robwiegman/luminixie/(list of files, drawings)

Other design files:
pcb/luminixie.dsn
