robwiegman/luminixie/pcb/luminixie.kicad_pcb

## KiCad design pcb/luminixie.kicad_pcb (2019-10-02)

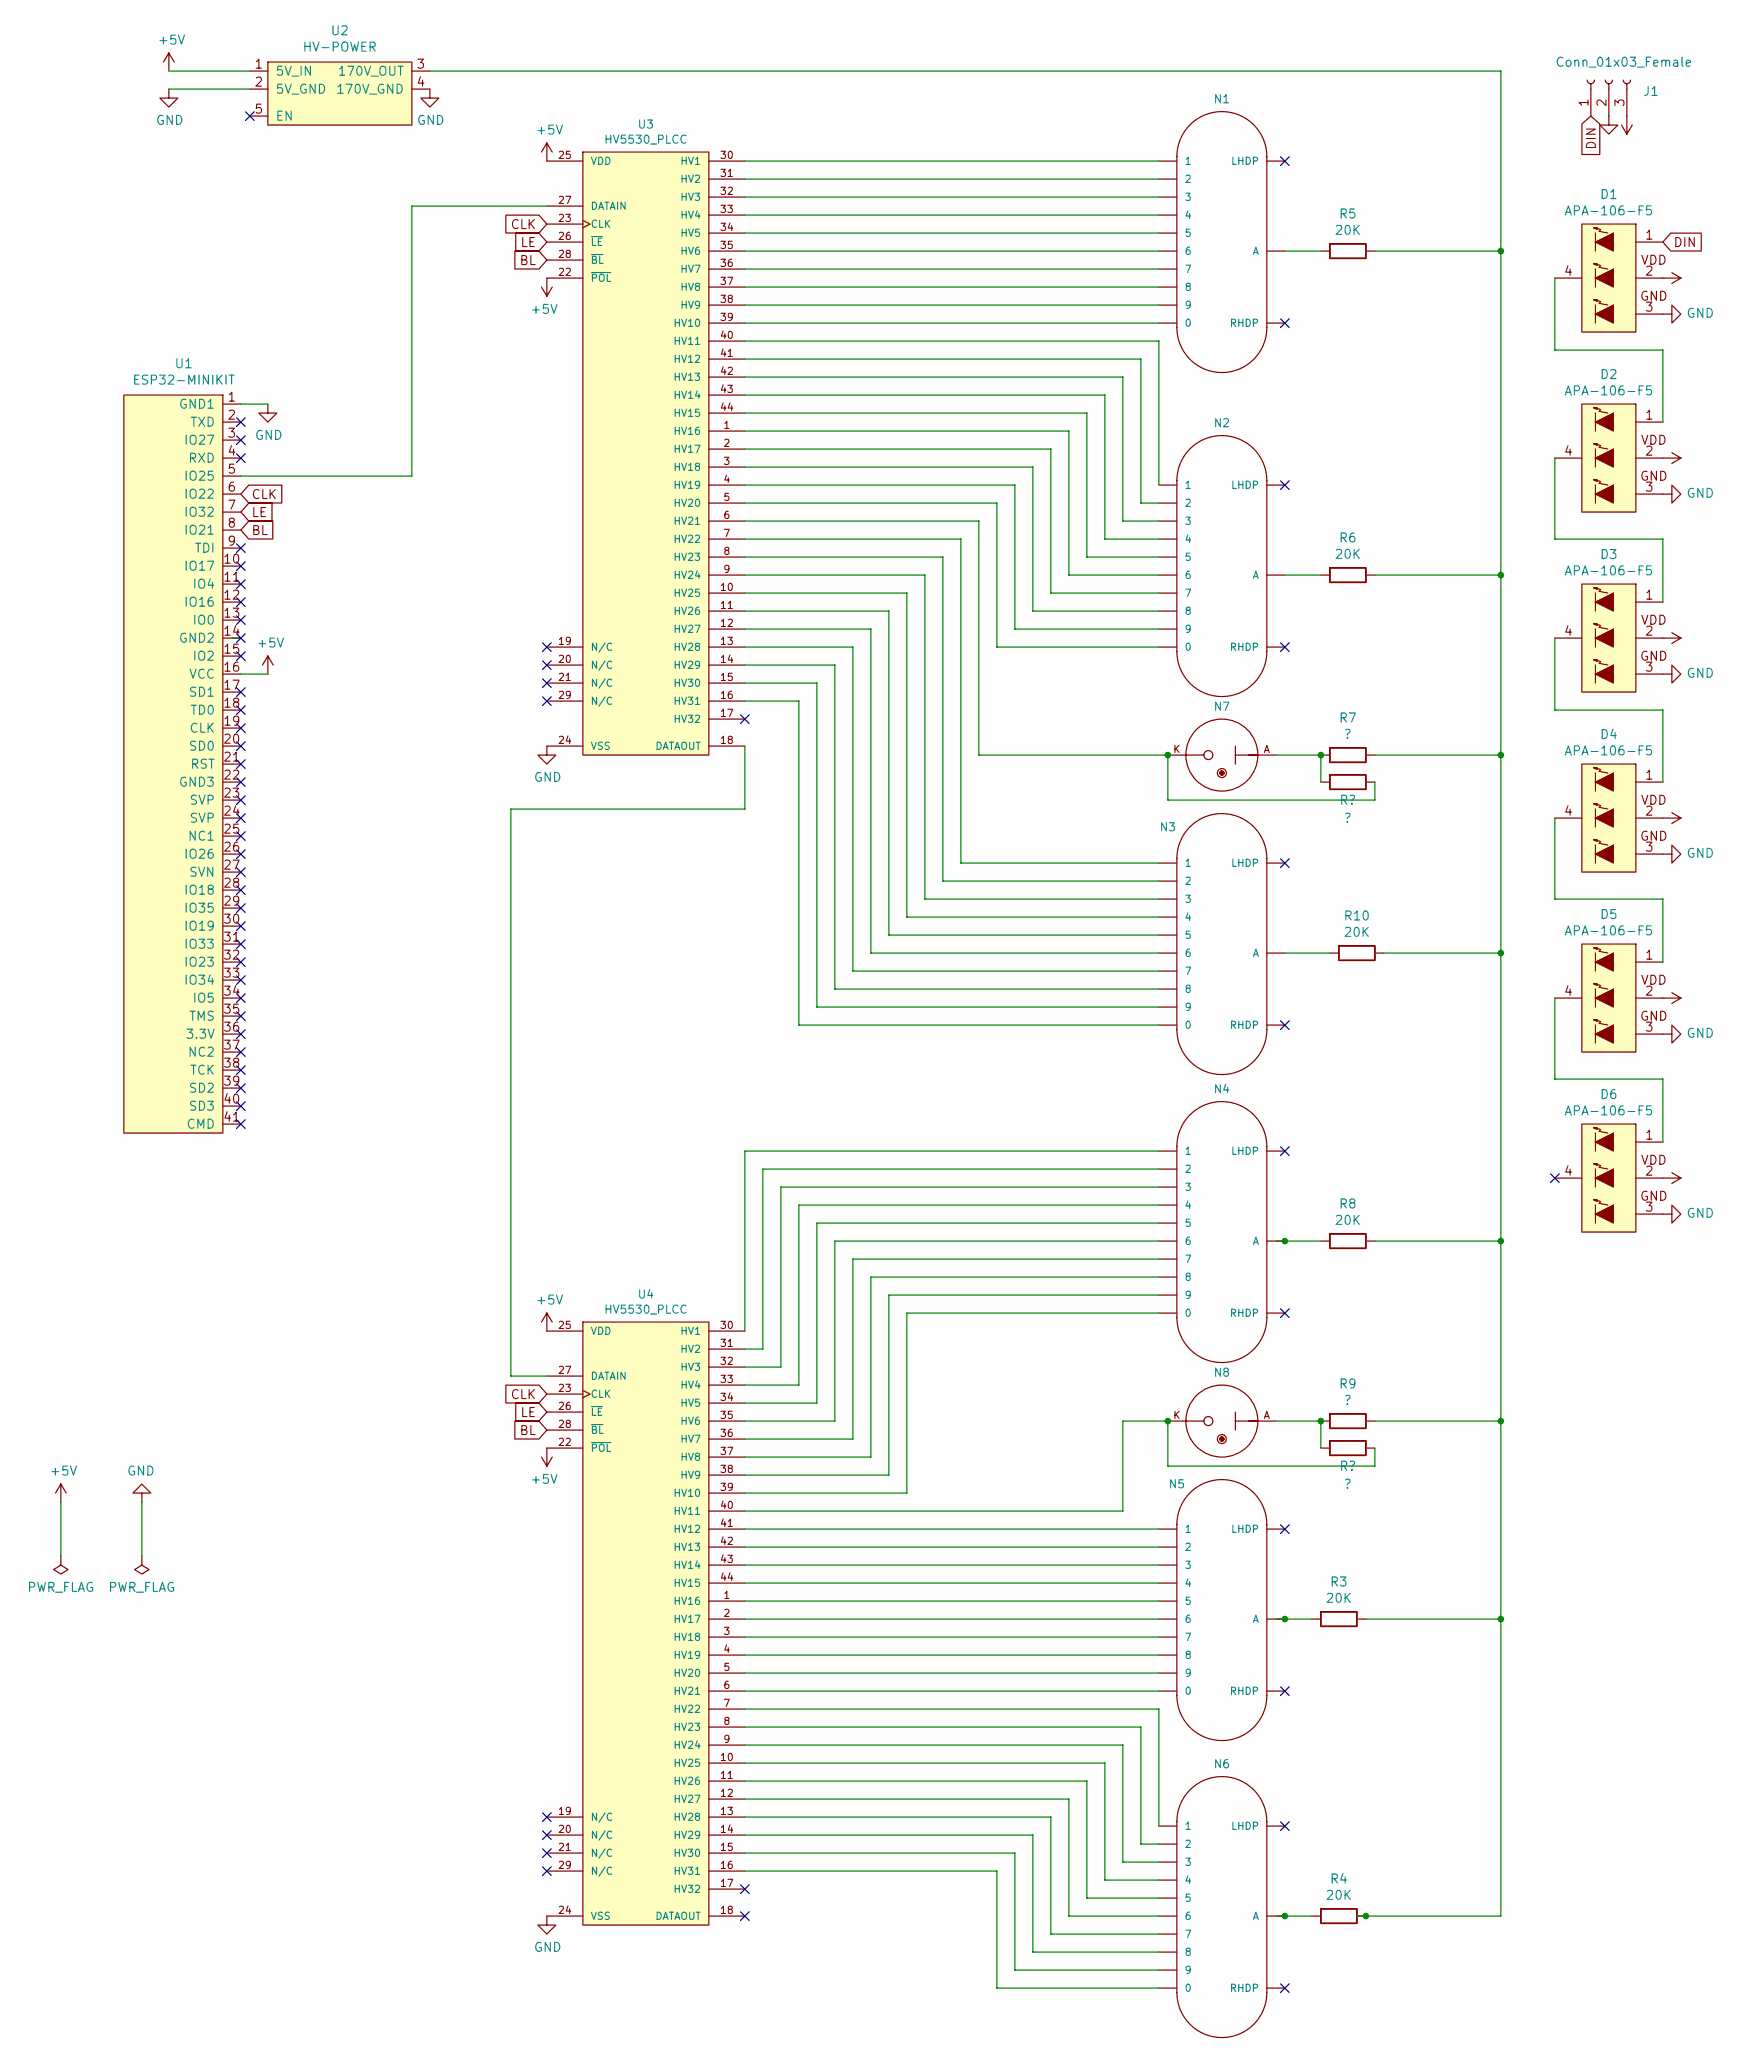
[picture p1: schematic luminixie.sch, LumiNixie clock]

Parts:
D1, D2, D3, D4, D5, D6: APA-106-F5; APA-106-F8
J1: Conn_01x03_Female; PinHeader_1x03_P2.54mm_Vertical
N1, N2, N3, N4, N5, N6: IN-14; nixies-us-IN-14
N7, N8: IN-3; nixies-us-IN-3
R3, R4, R5, R6, R8, R10: 20K; R_Axial_DIN0207_L6.3mm_D2.5mm_P7.62mm_Horizontal
R7, R9: ?; R_Axial_DIN0207_L6.3mm_D2.5mm_P7.62mm_Horizontal
U1: ESP32-MINIKIT; PinHeader_1x06_P2.54mm_Vertical
U2: HV-POWER; PinHeader_1x03_P2.54mm_Vertical
U3, U4: HV5530_PLCC; PLCC-44_THT-Socket

Connections:
+5V: D1.2 (VDD), D2.2 (VDD), D3.2 (VDD), D4.2 (VDD), D5.2 (VDD), D6.2 (VDD), J1.3, U1.16 (VCC), U2.1 (5V_IN), U3.22 (~POL), U3.25 (VDD), U4.22 (~POL), U4.25 (VDD)
BL: U1.8 (IO21), U3.28 (~BL), U4.28 (~BL)
CLK: U1.6 (IO22), U3.23 (CLK), U4.23 (CLK)
DIN: D1.1 (DIN), J1.1
GND: D1.3 (GND), D2.3 (GND), D3.3 (GND), D4.3 (GND), D5.3 (GND), D6.3 (GND), J1.2, U1.1 (GND1), U2.2 (5V_GND), U2.4 (170V_GND), U3.24 (VSS), U4.24 (VSS)
LE: U1.7 (IO32), U3.26 (~LE), U4.26 (~LE)
unnamed: D1.4 (DOUT), D2.1 (DIN)
unnamed: D2.4 (DOUT), D3.1 (DIN)
unnamed: D3.4 (DOUT), D4.1 (DIN)
unnamed: D4.4 (DOUT), D5.1 (DIN)
unnamed: D5.4 (DOUT), D6.1 (DIN)
unnamed: N1.0, U3.39 (HV10)
unnamed: N1.1, U3.30 (HV1)
unnamed: N1.2, U3.31 (HV2)
unnamed: N1.3, U3.32 (HV3)
unnamed: N1.4, U3.33 (HV4)
unnamed: N1.5, U3.34 (HV5)
unnamed: N1.6, U3.35 (HV6)
unnamed: N1.7, U3.36 (HV7)
unnamed: N1.8, U3.37 (HV8)
unnamed: N1.9, U3.38 (HV9)
unnamed: N1.A, R5.2
unnamed: N2.0, U3.5 (HV20)
unnamed: N2.1, U3.40 (HV11)
unnamed: N2.2, U3.41 (HV12)
unnamed: N2.3, U3.42 (HV13)
unnamed: N2.4, U3.43 (HV14)
unnamed: N2.5, U3.44 (HV15)
unnamed: N2.6, U3.1 (HV16)
unnamed: N2.7, U3.2 (HV17)
unnamed: N2.8, U3.3 (HV18)
unnamed: N2.9, U3.4 (HV19)
unnamed: N2.A, R6.2
unnamed: N3.0, U3.16 (HV31)
unnamed: N3.1, U3.7 (HV22)
unnamed: N3.2, U3.8 (HV23)
unnamed: N3.3, U3.9 (HV24)
unnamed: N3.4, U3.10 (HV25)
unnamed: N3.5, U3.11 (HV26)
unnamed: N3.6, U3.12 (HV27)
unnamed: N3.7, U3.13 (HV28)
unnamed: N3.8, U3.14 (HV29)
unnamed: N3.9, U3.15 (HV30)
unnamed: N3.A, R10.2
unnamed: N4.0, U4.39 (HV10)
unnamed: N4.1, U4.30 (HV1)
unnamed: N4.2, U4.31 (HV2)
unnamed: N4.3, U4.32 (HV3)
unnamed: N4.4, U4.33 (HV4)
unnamed: N4.5, U4.34 (HV5)
unnamed: N4.6, U4.35 (HV6)
unnamed: N4.7, U4.36 (HV7)
unnamed: N4.8, U4.37 (HV8)
unnamed: N4.9, U4.38 (HV9)
unnamed: N4.A, R8.2
unnamed: N5.0, U4.6 (HV21)
unnamed: N5.1, U4.41 (HV12)
unnamed: N5.2, U4.42 (HV13)
unnamed: N5.3, U4.43 (HV14)
unnamed: N5.4, U4.44 (HV15)
unnamed: N5.5, U4.1 (HV16)
unnamed: N5.6, U4.2 (HV17)
unnamed: N5.7, U4.3 (HV18)
unnamed: N5.8, U4.4 (HV19)
unnamed: N5.9, U4.5 (HV20)
unnamed: N5.A, R3.2
unnamed: N6.0, U4.16 (HV31)
unnamed: N6.1, U4.7 (HV22)
unnamed: N6.2, U4.8 (HV23)
unnamed: N6.3, U4.9 (HV24)
unnamed: N6.4, U4.10 (HV25)
unnamed: N6.5, U4.11 (HV26)
unnamed: N6.6, U4.12 (HV27)
unnamed: N6.7, U4.13 (HV28)
unnamed: N6.8, U4.14 (HV29)
unnamed: N6.9, U4.15 (HV30)
unnamed: N6.A, R4.2
unnamed 90: N7.A, R7.2; also elsewhere on the board
unnamed 91: N7.K, U3.6 (HV21); also elsewhere on the board
unnamed 92: N8.A, R9.2; also elsewhere on the board
unnamed 93: N8.K, U4.40 (HV11); also elsewhere on the board
unnamed: R3.1, R4.1, R5.1, R6.1, R7.1, R8.1, R9.1, R10.1, U2.3 (170V_OUT)
unnamed: U1.5 (IO25), U3.27 (DATAIN)
unnamed: U3.18 (DATAOUT), U4.27 (DATAIN)

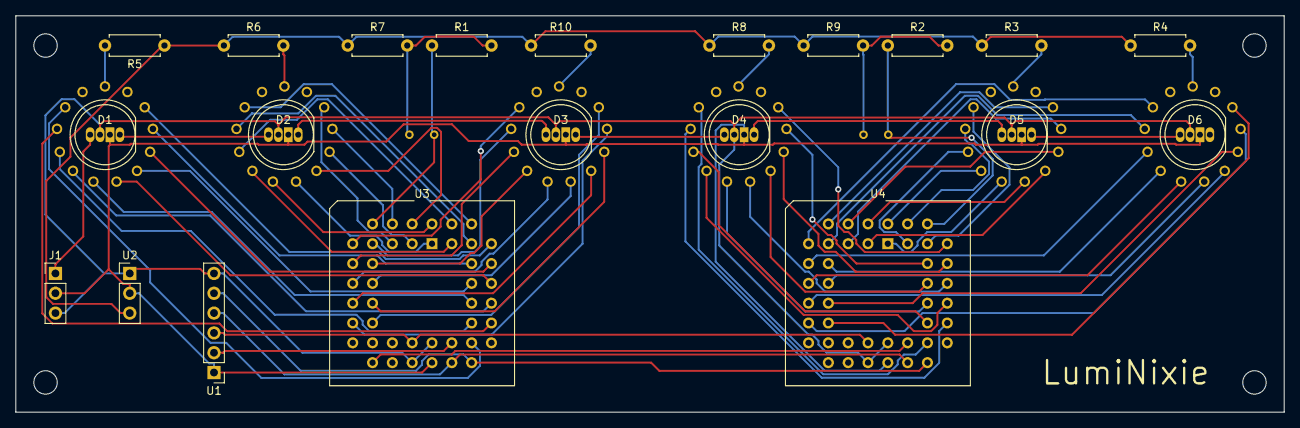
[picture p2: board luminixie.kicad_pcb from above]

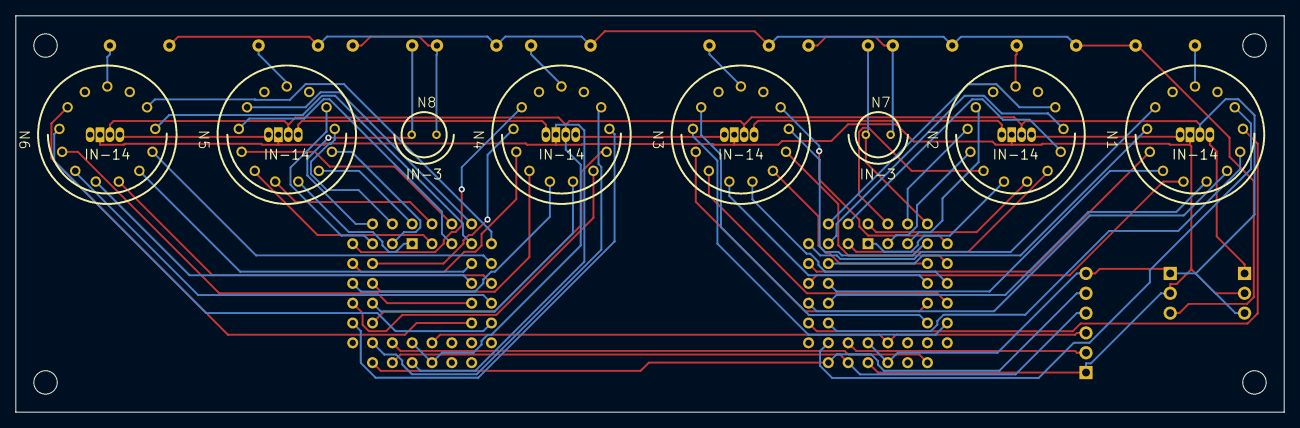
[picture p3: board luminixie.kicad_pcb from below]

Board: 2 copper layers, 162.6 x 50.8 mm, 33 parts (8 on the bottom side), 84 nets.

Other parts of the board:
R1, R2: ?; R_Axial_DIN0207_L6.3mm_D2.5mm_P7.62mm_Horizontal
REF1, REF2, REF5, REF6: MountingHole_3mm

Their connections:
unnamed 90: R1.2; also elsewhere on the board
unnamed 91: R1.1; also elsewhere on the board
unnamed 92: R2.2; also elsewhere on the board
unnamed 93: R2.1; also elsewhere on the board
