robwiegman/luminixie/(commit log)

2019-09-24 Add drillholes, add Luminixie logo, add edge cuts, delete netlist, add dependencies (apa-106, nixies)
    [luminixie.kicad_pcb]
2019-09-24 Set local clearance for apa-106 to suppress DRC error
    [luminixie.kicad_pcb]
2019-09-29 Voltage divider for IN-3
    [luminixie.dsn, luminixie.kicad_pcb, luminixie.sch]
2019-10-02 Move labels of nixies on silk layers, so that they have no overlap with drill holes
    [luminixie.kicad_pcb]
2019-11-07 Add Gerbers
    [luminixie-B_Cu.gbr, luminixie-B_Mask.gbr, luminixie-B_Paste.gbr, luminixie-B_SilkS.gbr, luminixie-Edge_Cuts.gbr, luminixie-F_Cu.gbr, luminixie-F_Mask.gbr, luminixie-F_Paste.gbr]
2019-11-30 Moved pcb to own subdirectory, add subdirectory for Arduino code
    [luminixie-B_Cu.gbr, luminixie-B_Mask.gbr, luminixie-B_Paste.gbr, luminixie-B_SilkS.gbr, luminixie-Edge_Cuts.gbr, luminixie-F_Cu.gbr, luminixie-F_Mask.gbr, luminixie-F_Paste.gbr]
2019-12-01 Add README.md to Arduino
2019-12-01 Add temperature and humidity sensor
2019-12-17 Add nixie tube display setting to UI
2019-12-17 Never light all tubes + dots at once (it sometimes causes issues with the power supply)
    [luminixie.ino]
2019-12-21 Remove subdirectories because SPIFFS file names can be 32 bytes max (see https://github.com/me-no-dev/arduino-esp32fs-plugin/issues/3)
2019-12-31 Add configurable led-mode, add led-mode "Rainbow"
2019-12-31 Add knight rider led mode, speed up runAntiCathodePoisoningSequence2
2020-01-02 Speed up antiCathodePoisoningSequence, only send changed brightness to leds, add NewYears ritual
